MMantiaLU/3DP-EDUSPEC-Kit/STEP Files/(C)Mounting_Post.step

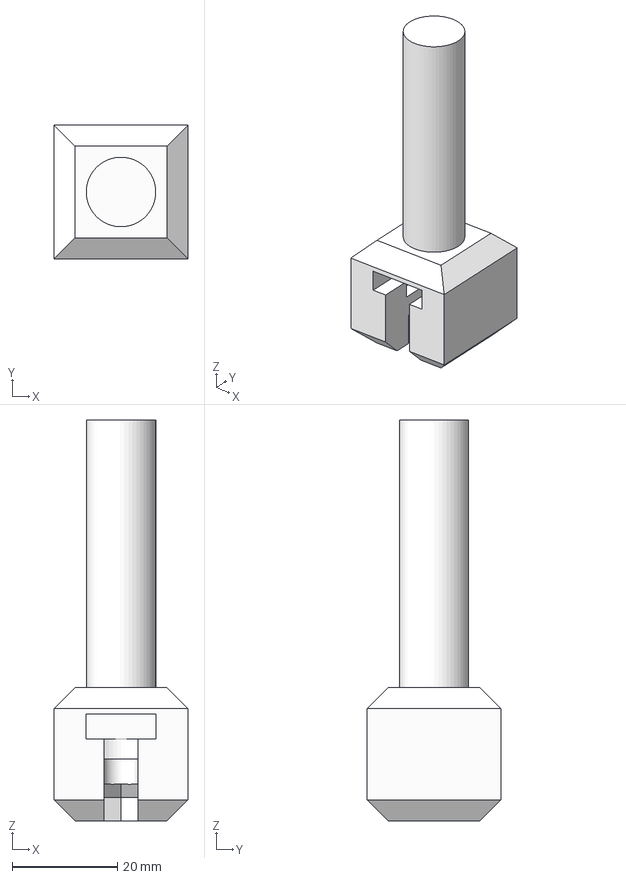
[picture p16: CAD file, 2021-05-14]
STEP Files/(C)Mounting_Post.step
25.4 x 25.4 x 76.2 mm
