MMantiaLU/3DP-EDUSPEC-Kit/STEP Files/(L)Laser_Pen_Mount.step

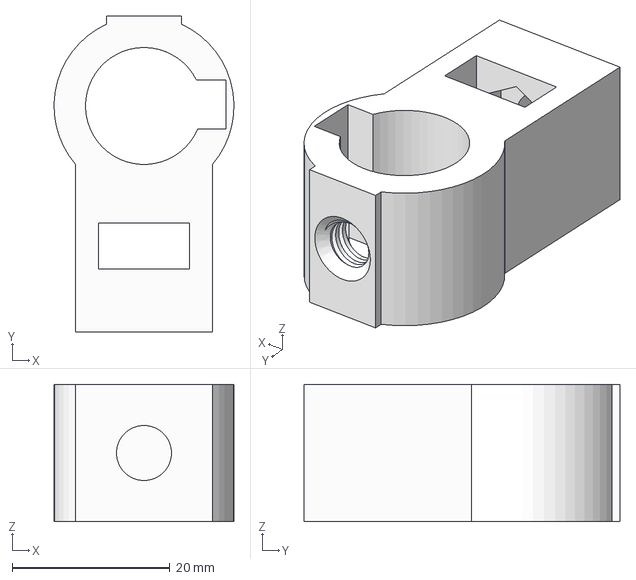
[picture p17: CAD file, 2021-05-14]
STEP Files/(L)Laser_Pen_Mount.step
22.8 x 40.1 x 17.4 mm
