MMantiaLU/3DP-EDUSPEC-Kit/STEP Files/(J)FDS100_PD_Insert.step

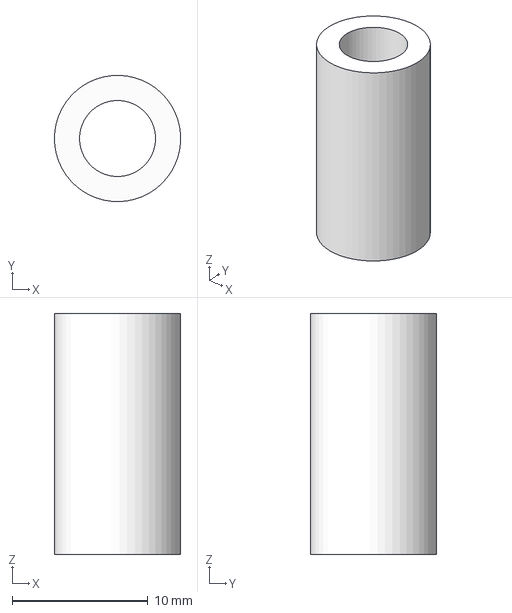
[picture p18: CAD file, 2021-05-14]
STEP Files/(J)FDS100_PD_Insert.step
9.29 x 9.30 x 17.8 mm
