MMantiaLU/3DP-EDUSPEC-Kit/STEP Files/(B)Post_Holder_w_Clamping_Forks.step

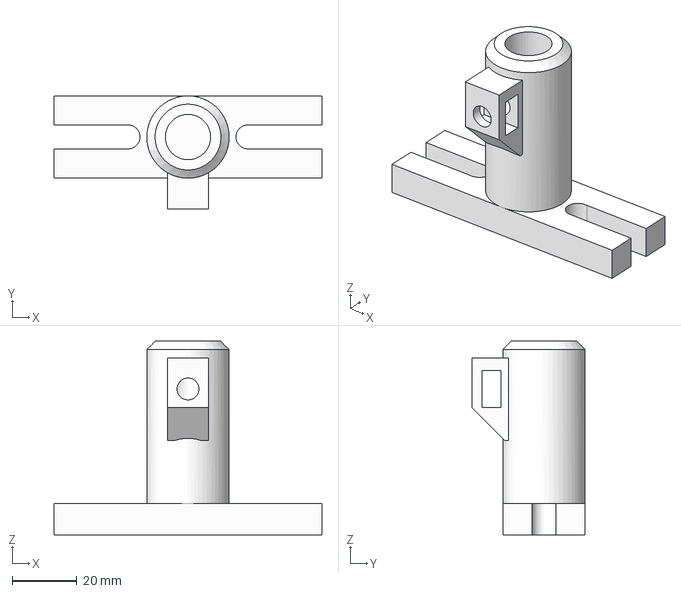
[picture p19: CAD file, 2021-05-14]
STEP Files/(B)Post_Holder_w_Clamping_Forks.step
82.7 x 34.9 x 59.7 mm
