MMantiaLU/3DP-EDUSPEC-Kit/STEP Files/(J)FDS100_PD_Sleeve.step

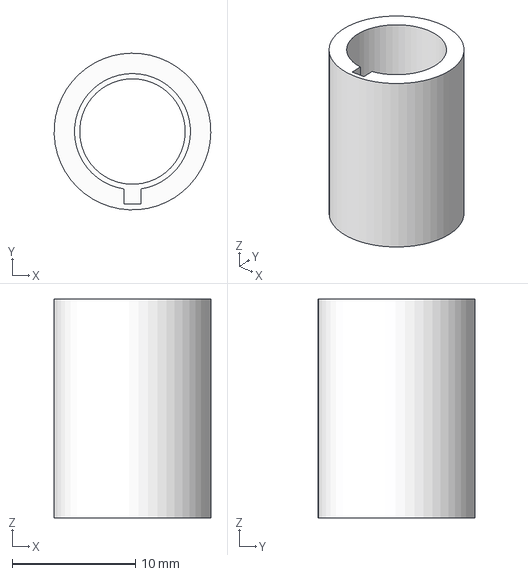
[picture p20: CAD file, 2021-05-14]
STEP Files/(J)FDS100_PD_Sleeve.step
12.7 x 12.7 x 17.8 mm
