MMantiaLU/3DP-EDUSPEC-Kit/STEP Files/(N)Cuvette_Mount_1-cm.step

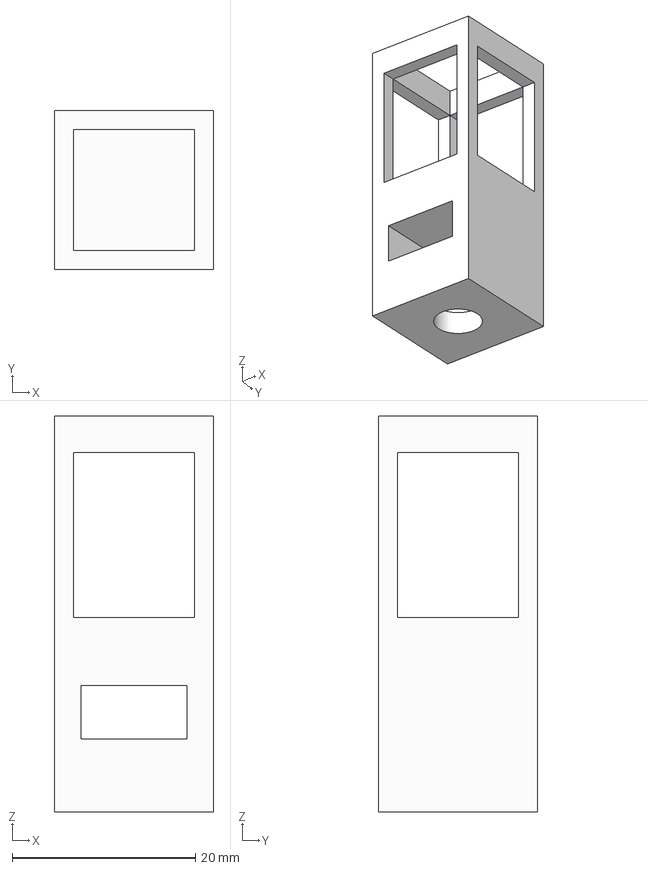
[picture p21: CAD file, 2021-05-14]
STEP Files/(N)Cuvette_Mount_1-cm.step
17.4 x 17.4 x 43.3 mm
