MMantiaLU/3DP-EDUSPEC-Kit/STEP Files/(H)1-in_Mount.step

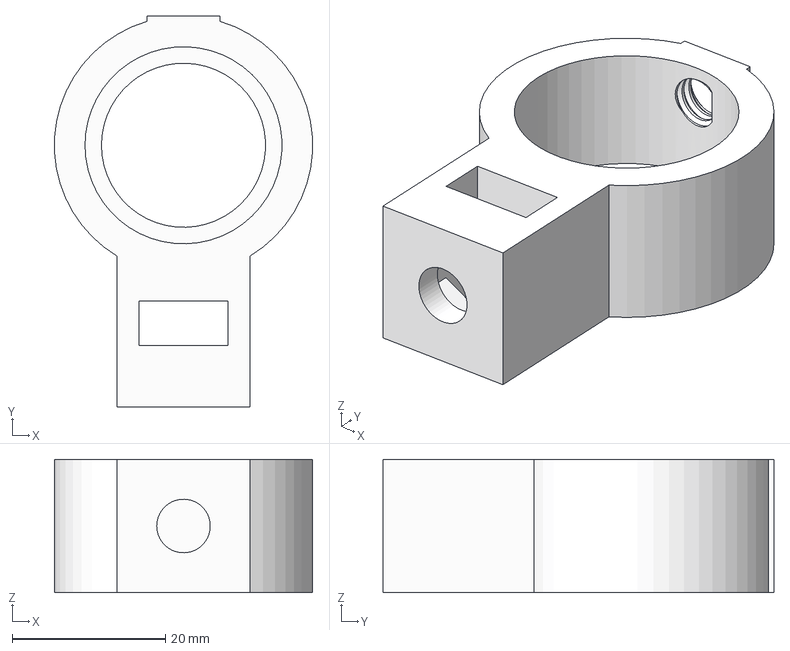
[picture p22: CAD file, 2021-05-14]
STEP Files/(H)1-in_Mount.step
33.6 x 51.0 x 17.4 mm
