MMantiaLU/3DP-EDUSPEC-Kit/STEP Files/(F)Rotating_Analyzer_Gear.step

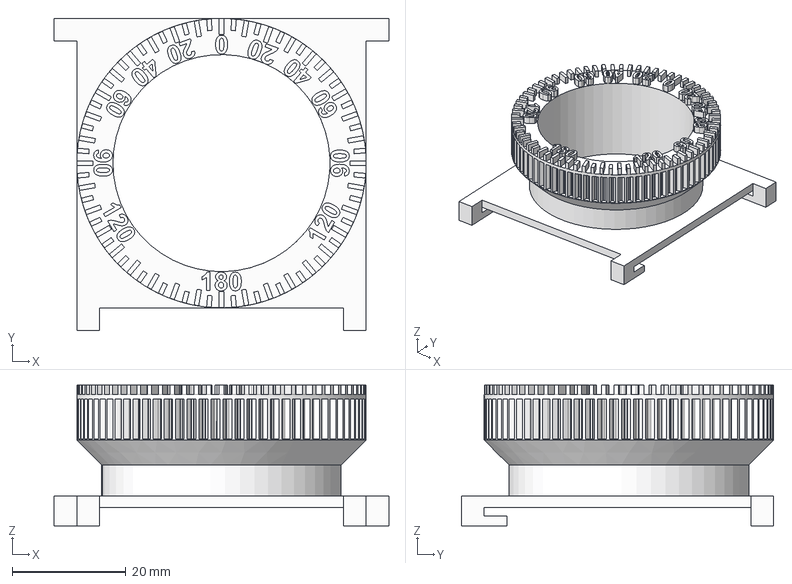
[picture p23: CAD file, 2021-05-14]
STEP Files/(F)Rotating_Analyzer_Gear.step
58.8 x 54.8 x 24.7 mm
