MMantiaLU/3DP-EDUSPEC-Kit/STEP Files/(H)1-in_Insert.step

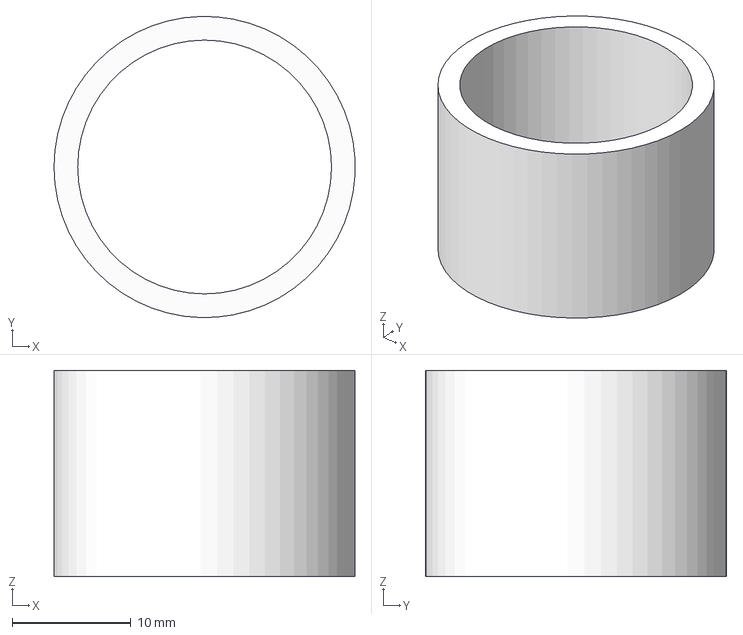
[picture p24: CAD file, 2021-05-14]
STEP Files/(H)1-in_Insert.step
25.4 x 25.4 x 17.4 mm
