MMantiaLU/3DP-EDUSPEC-Kit/STEP Files/(G)0.5in_Mount.step

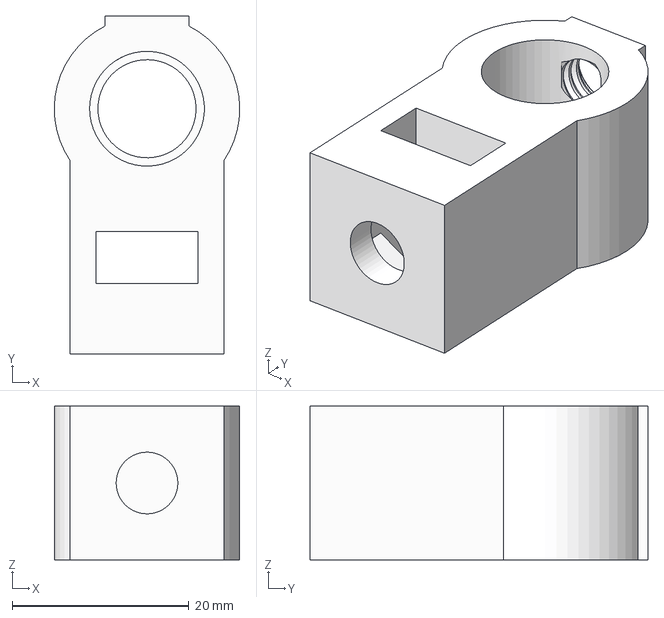
[picture p25: CAD file, 2021-05-14]
STEP Files/(G)0.5in_Mount.step
21.0 x 38.3 x 17.4 mm
