MMantiaLU/3DP-EDUSPEC-Kit/STEP Files/(G)0.5in_Insert.step

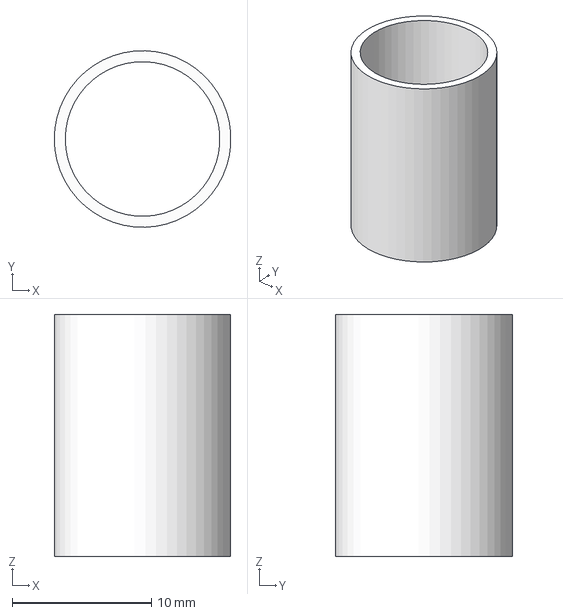
[picture p26: CAD file, 2021-05-14]
STEP Files/(G)0.5in_Insert.step
12.7 x 12.7 x 17.4 mm
