MMantiaLU/3DP-EDUSPEC-Kit/STEP Files/(K)LED_Flashlight_Mount.step

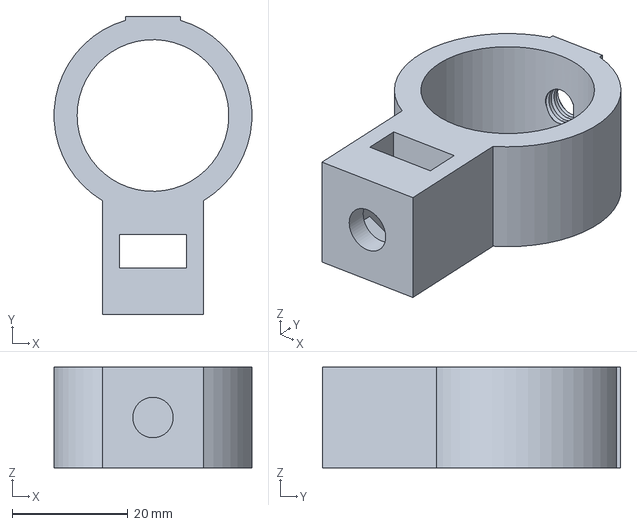
[picture p27: CAD file, 2021-05-14]
STEP Files/(K)LED_Flashlight_Mount.step
34.1 x 51.5 x 17.4 mm
