MMantiaLU/3DP-EDUSPEC-Kit/STEP Files/(I)1.5-in_Insert.step

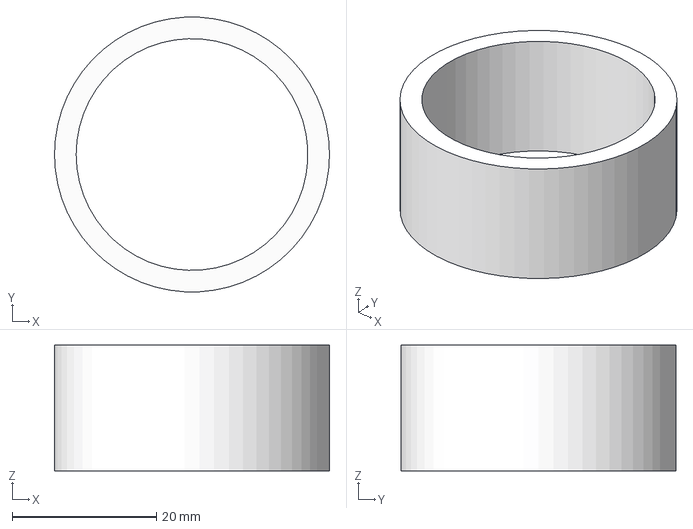
[picture p28: CAD file, 2021-05-14]
STEP Files/(I)1.5-in_Insert.step
38.1 x 38.0 x 17.4 mm
