MMantiaLU/3DP-EDUSPEC-Kit/STEP Files/(I)1.5-in_Mount.step

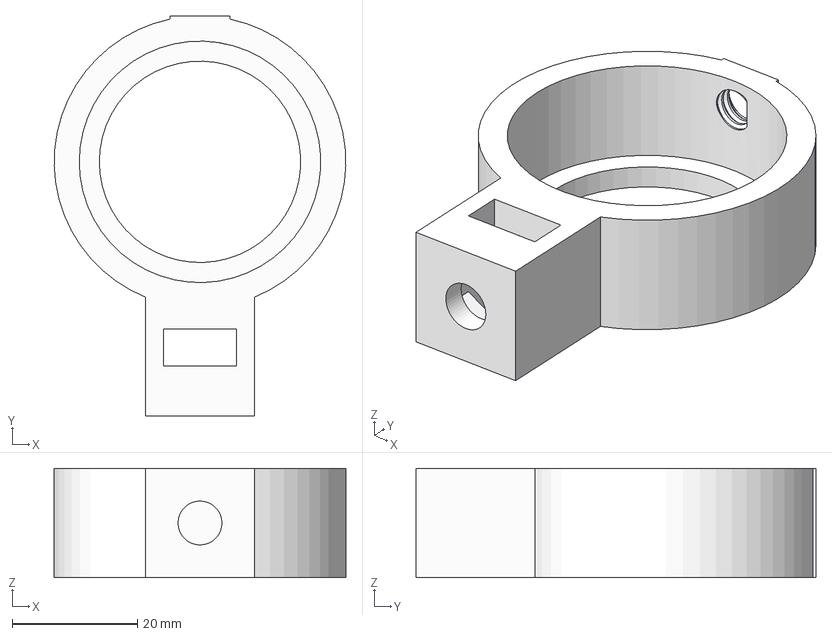
[picture p29: CAD file, 2021-05-14]
STEP Files/(I)1.5-in_Mount.step
46.5 x 63.8 x 17.4 mm
