MMantiaLU/3DP-EDUSPEC-Kit/STEP Files/(F)Rotating_Analyzer_Body.step

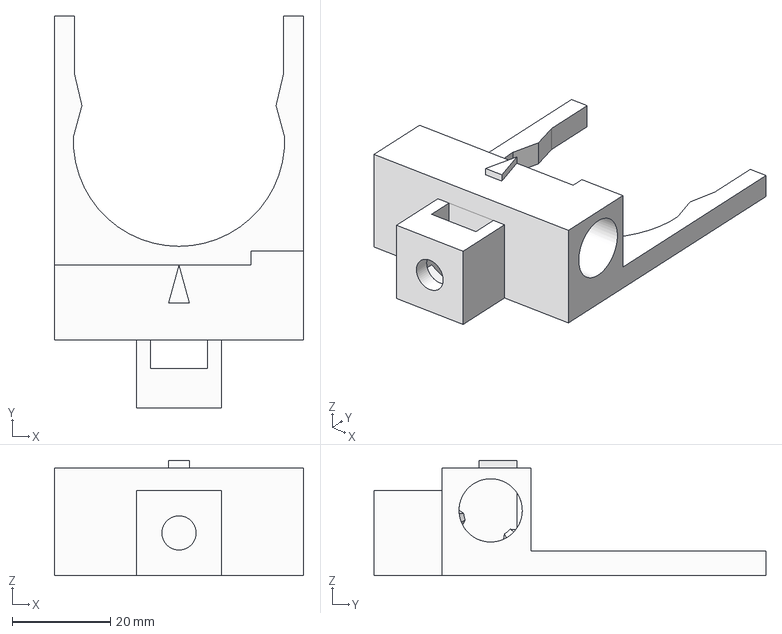
[picture p30: CAD file, 2021-05-14]
STEP Files/(F)Rotating_Analyzer_Body.step
50.8 x 79.9 x 23.5 mm
