MMantiaLU/3DP-EDUSPEC-Kit/STEP Files/(E)2-in_Square_Mount.step

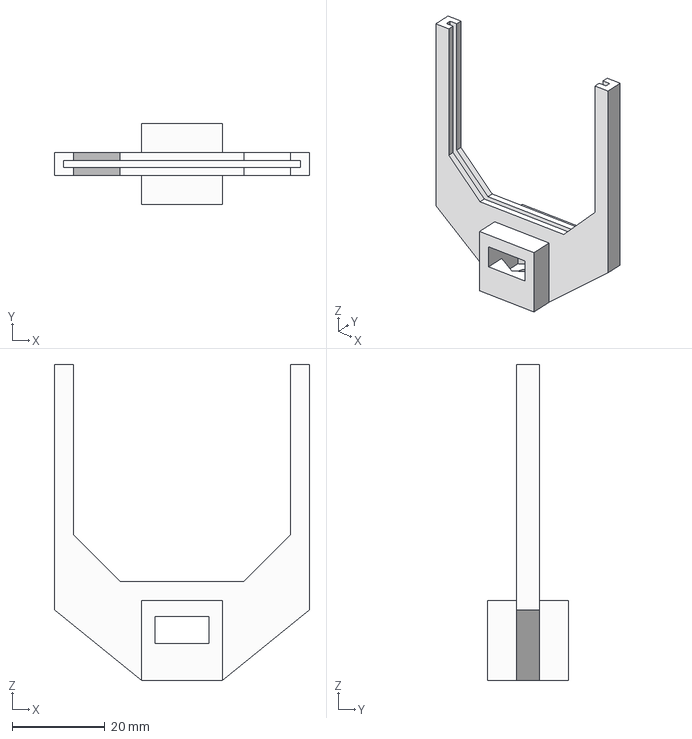
[picture p31: CAD file, 2021-05-14]
STEP Files/(E)2-in_Square_Mount.step
55.1 x 17.4 x 68.2 mm
