MMantiaLU/3DP-EDUSPEC-Kit/STEP Files/(M)Laser_Pen_OnOff_Toggle.step

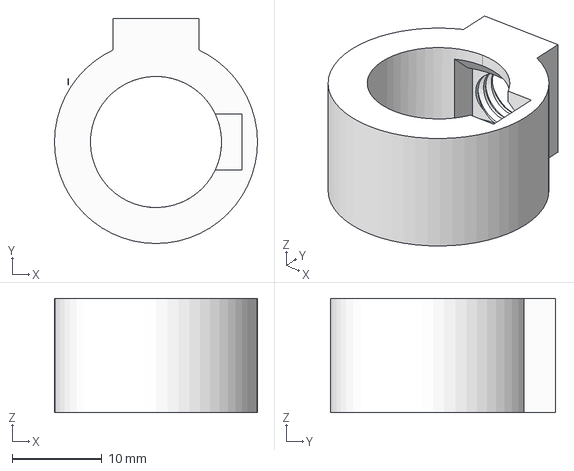
[picture p32: CAD file, 2021-05-14]
STEP Files/(M)Laser_Pen_OnOff_Toggle.step
22.6 x 25.0 x 12.7 mm
