MMantiaLU/3DP-EDUSPEC-Kit/STEP Files/(D)1.25-in_Square_Mount.step

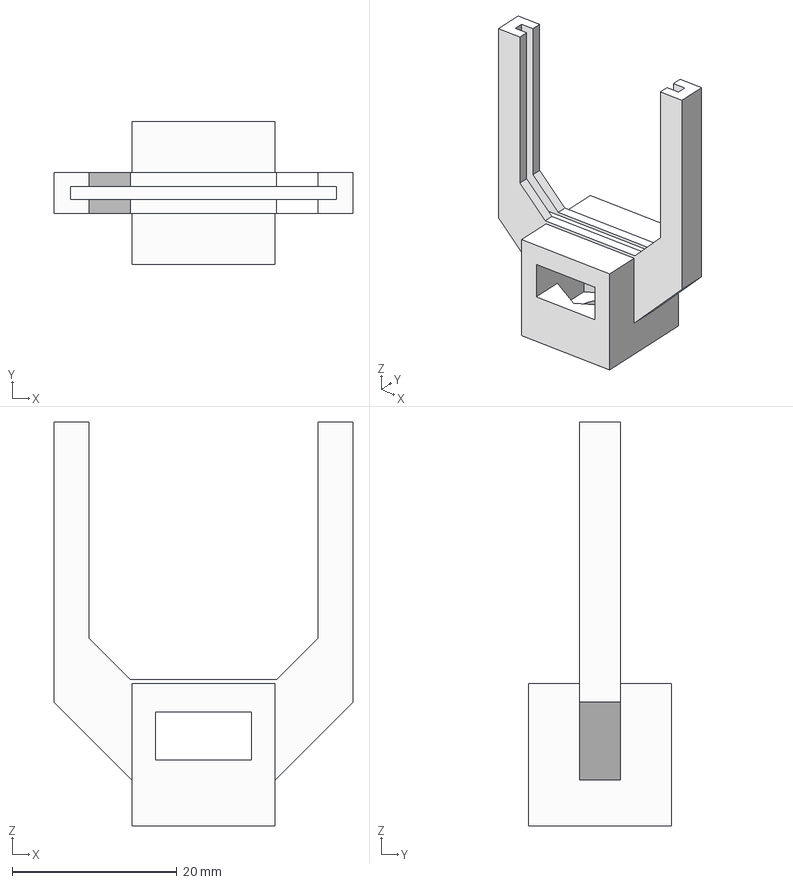
[picture p33: CAD file, 2021-05-14]
STEP Files/(D)1.25-in_Square_Mount.step
36.2 x 17.4 x 49.0 mm
