MMantiaLU/3DP-EDUSPEC-Kit/(list of files, cad)

Other CAD files:
STEP Files/(Q)0.25-20_Mount_Screw.step
STL Files/(B)Post_Holder_w_Clamping_Forks.stl
STL Files/(C)Mounting_Post.stl
STL Files/(D)1.25-in_Square_Mount.stl
STL Files/(E)2-in_Square_Mount.stl
STL Files/(F)Rotating_Analyzer_Body.stl
STL Files/(F)Rotating_Analyzer_Gear.stl
STL Files/(F)Rotating_Analyzer_Screw.stl
STL Files/(G)0.5in_Insert.stl
STL Files/(G)0.5in_Mount.stl
STL Files/(H)1-in_Insert.stl
STL Files/(H)1-in_Mount.stl
STL Files/(I)1.5-in_Insert.stl
STL Files/(I)1.5-in_Mount.stl
STL Files/(J)FDS100_PD_Insert.stl
STL Files/(J)FDS100_PD_Sleeve.stl
STL Files/(K)LED_Flashlight_Mount.stl
STL Files/(L)Laser_Pen_Mount.stl
STL Files/(M)Laser_Pen_OnOff_Toggle.stl
STL Files/(N)Cuvette_Mount_1-cm.stl
STL Files/(Q)0.25-20_Mount_Screw.stl
